RickyZiegahn/Oven-Temperature-Controller/(commit log)

2018-07-26 Version 1.1
    Added flags to disable the oven if a thermocouple is not functioning and added a sample thermocouple that is independent from the everything else.
2018-07-28 Version 1.2
    Updated to include plotting in logging, removed the specialized functions for sample temperature readings (python), permanently disabled heater if there is a thermocouple problem for that heater, generally cleaned everything up a bit
    [oven_temperature_control.ino, oven_temperature_control.py]
2018-07-28 Version 1.2
    [100 Degrees.xlsx, 150 Degrees D modification.xlsx, 150 Degrees D.xlsx, 150 Degrees P modification.xlsx]
2018-07-31 Version 1.4
    Added exceptions for errors, moved logs to a folder, changed the pins used in Arduino, updated documentation
    [100 Degrees.xlsx, 150 Degrees D modification.xlsx, 150 Degrees D.xlsx, 150 Degrees P modification.xlsx]
2018-08-03 Version 1.5
    Added an option to disable a sample channel.
